MRC757/ESP32-WWVB-NTP-Time-Server/TimeManager.h

/**
 * @file      TimeManager.h
 * @brief     Internal Time Management for WWVB Clock
 * @details   Maintains time between WWVB syncs using ESP32 millis()
 */

#ifndef TIMEMANAGER_H
#define TIMEMANAGER_H

#include <Arduino.h>
#include <stdint.h>

// ============================================================================
// Data Structures
// ============================================================================

/**
 * @brief Structure to hold date and time
 */
struct ClockTime {
    uint16_t year;      // Full year (e.g., 2025)
    uint8_t month;      // Month (1-12)
    uint8_t day;        // Day of month (1-31)
    uint8_t hour;       // Hour (0-23)
    uint8_t minute;     // Minute (0-59)
    uint8_t second;     // Second (0-59)
};

// ============================================================================
// TimeManager Class Definition
// ============================================================================

/**
 * @brief Time Manager Class
 * @details Maintains internal time using ESP32 millis() timer
 *          Time is stored as UTC and converted to local time on request
 */
class TimeManager {
public:
    /**
     * @brief Constructor
     */
    TimeManager();
    
    /**
     * @brief Set the current UTC time
     * @param year Full year (e.g., 2025)
     * @param month Month (1-12)
     * @param day Day of month (1-31)
     * @param hour Hour (0-23)
     * @param minute Minute (0-59)
     * @param second Second (0-59)
     */
    void setTime(uint16_t year, uint8_t month, uint8_t day,
                 uint8_t hour, uint8_t minute, uint8_t second);
    
    /**
     * @brief Update internal time (call once per second)
     * @details Increments internal second counter based on millis()
     */
    void tick();
    
    /**
     * @brief Get current UTC time
     * @return ClockTime structure with UTC time
     */
    ClockTime getUTCTime();
    
    /**
     * @brief Get current local time with UTC offset and DST
     * @param utcOffset Hours offset from UTC (e.g., -5 for EST)
     * @param dst True if Daylight Saving Time is active
     * @return ClockTime structure with local time
     */
    ClockTime getLocalTime(int8_t utcOffset, bool dst = false);
    
    /**
     * @brief Get Unix timestamp (seconds since Jan 1, 1970)
     * @return Unix timestamp
     */
    uint32_t getUnixTime();

    /**
     * @brief Get current milliseconds within the second (0-999)
     * @details Computed on-the-fly from accumulated millis, no side effects
     * @return Milliseconds (0-999)
     */
    uint16_t getMilliseconds();

    /**
     * @brief Get a coherent (seconds, milliseconds) pair, safe against second-boundary races.
     * @param outUnixSeconds  Output: current Unix timestamp (integer seconds)
     * @param outMillis       Output: milliseconds within the current second (0–999)
     */
    void getTimeSnapshot(uint32_t& outUnixSeconds, uint16_t& outMillis);
    
    /**
     * @brief Set time from Unix timestamp
     * @param unixTime Seconds since Jan 1, 1970
     */
    void setUnixTime(uint32_t unixTime);

    /**
     * @brief Correct the integer second without disturbing the sub-second accumulator.
     * @details Use this for DS3231 drift corrections where only the integer second changes.
     *          Unlike setUnixTime(), this does NOT reset _accumMillis or _lastTickMillis,
     *          preserving the NTP fractional-second accuracy accumulated since the last sync.
     * @param unixTime  The corrected Unix timestamp (integer seconds)
     */
    void setUnixTimePreserveMillis(uint32_t unixTime);

    /**
     * @brief Set the sub-second accumulator after a setUnixTime() call.
     * @details Call immediately after setUnixTime() to restore sub-second phase.
     *          Typical use: pass irqProcessingDelay (ms) so the clock reads
     *          corrected_second + irq_latency, matching the true time at IRQ fire.
     * @param ms  Milliseconds within the current second (0–999)
     */
    void setSubSecondOffset(uint16_t ms);

    /**
     * @brief Lock the timebase to an external second-boundary anchor.
     * @details The supplied unixSecond is the UTC second that began at edgeMicros.
     *          Subsequent reads derive both whole seconds and sub-second phase from
     *          the elapsed microseconds since that anchor instead of free-running
     *          solely on millis().
     * @param unixSecond UTC second at the boundary
     * @param edgeMicros micros() captured at that second boundary
     */
    void setRTCPhaseAnchor(uint32_t unixSecond, uint32_t edgeMicros);

    /**
     * @brief Clear any external phase lock and fall back to millis()-based holdover.
     */
    void clearRTCPhaseAnchor();

    /**
     * @brief True when the clock is currently disciplined by an external second edge.
     */
    bool hasRTCPhaseAnchor() const;

    
    /**
     * @brief Check if time has been set (synced at least once)
     * @return true if time has been set
     */
    bool isTimeSet();
    
    /**
     * @brief Get seconds since last time set
     * @return Seconds elapsed since setTime() was called
     */
    uint32_t getSecondsSinceSync();
    
    /**
     * @brief Calculate day of week (0=Sunday, 6=Saturday)
     * @param year Full year
     * @param month Month (1-12)
     * @param day Day of month (1-31)
     * @return Day of week (0-6)
     */
    static int calculateDayOfWeek(uint16_t year, uint8_t month, uint8_t day);
    
    /**
     * @brief Check if year is a leap year
     * @param year Full year
     * @return true if leap year
     */
    static bool isLeapYear(uint16_t year);
    
    /**
     * @brief Get number of days in a month
     * @param year Full year (needed for February leap year check)
     * @param month Month (1-12)
     * @return Number of days in the month
     */
    static uint8_t daysInMonth(uint16_t year, uint8_t month);

private:
    // Internal time storage (UTC)
    uint16_t _year;
    uint8_t _month;
    uint8_t _day;
    uint8_t _hour;
    uint8_t _minute;
    uint8_t _second;
    
    // Timing tracking
    unsigned long _lastTickMillis;      // millis() at last tick
    unsigned long _syncMillis;          // millis() when time was set
    bool _timeSet;                      // Has time been set?
    
    // Accumulated milliseconds for sub-second accuracy
    uint32_t _accumMillis;   // uint32 prevents overflow up to ~49 days

    // Optional RTC-disciplined phase anchor
    bool _rtcPhaseLocked;
    uint32_t _rtcAnchorUnixSecond;
    uint32_t _rtcAnchorMicros;
    
    /**
     * @brief Increment internal time by one second
     */
    void incrementSecond();
    
    /**
     * @brief Normalize time values after arithmetic operations
     */
    void normalizeTime();
    
    /**
     * @brief Add hours to current time (can be negative)
     * @param hours Hours to add (positive or negative)
     */
    void addHours(int8_t hours);

    /**
     * @brief Convert Unix seconds to calendar fields.
     */
    static ClockTime unixToClockTime(uint32_t unixTime);
};

#endif // TIMEMANAGER_H
