MRC757/ESP32-WWVB-NTP-Time-Server/(commit log)

2026-03-23 Fix tracking timeout, antenna selection, time lag, and build compatibility
    - Fix tracking mode reception timeout starting at schedule time instead of
    actual :55 write; timeout now resets when Control 0 is written so syncs
    scheduled more than 30s before :55 no longer immediately time out
    - Fix tracking mode always using Ant1 regardless of history; now selects
    antenna with higher historical success count, matching normal mode behavior
    - Fix normal-mode sync web callback silently no-op when tracking pending
    - Fix ~1s display lag: syncFromDS3231() now requires ≥2s discrepancy before
    calling setTime(), eliminating the tick()/DS3231 second-boundary race that
    rolled back TimeManager eve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
    [CaptivePortal.cpp, CaptivePortal.h, ES100.cpp, ES100.h, NTPServer.cpp, NTPServer.h, ReceptionHistory.cpp, ReceptionHistory.h]
2026-03-23 Update MODIFICATIONS.md with 2026-03-23 changes
    Documents fixes 8–14: tracking timeout, antenna selection, normal sync
    callback, 1-second display lag, latency compensation, SPIFFS build fix,
    and favicon.ico handler.
2026-03-25 Improve time accuracy: IRQ latency, NTP RTT, tracking sanity check, NTP RFC compliance
    F1 Capture ES100 IRQ timestamp in ISR; measure IRQ-to-handler delay
    F2 Apply measured IRQ delay as whole-second correction (1s floor) for normal
    mode; tracking back-computes Unix second from :55-write anchor + WWVB field
    F3 10s DS3231 read-back suppression after WWVB sync (trust window)
    F4 uint32_t _accumMillis to prevent silent overflow at 65s
    F5 Atomic NTP timestamp via getTimeSnapshot() double-read pattern
    F6 setUnixTimePreserveMillis() preserves sub-second accumulator on DS3231 drift corrections
    F7 Dynamic NTP Root Dispersion grows at DS3231 2ppm drift rate since last sync
    F8 NTP stratum de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
    [NTPServer.cpp, NTPServer.h, TimeManager.cpp, TimeManager.h, config.h, wwvb_clock.ino]
2026-03-27 Add time accuracy chain section and clarify ES100 crystal note in README
    Documents each stage of the WWVB→NTP→PC→time.gov error chain with typical
    error magnitudes and recommended Windows NTP poll interval settings.
    Clarifies that the ES100-MOD includes the 16 MHz crystal onboard.
2026-04-06 Add nightly normal-mode anchor and remove 1s floor from normal sync
    Nightly anchor (config.h, wwvb_clock.ino):
    - Force a full normal-mode WWVB sync at the start of each night (10 PM local)
    and retry every hour until one succeeds, then resume tracking mode.
    - Prevents tracking mode from perpetuating clock errors larger than the ES100's
    ±4 s timing tolerance, which cause every tracking sync to reinforce rather than
    correct the error (self-perpetuating cycle).
    - Controlled by NIGHTLY_NORMAL_SYNC_HOURS (default 20h); lastNormalSuccessMillis
    tracks the last successful full-frame decode.
    Remove 1s floor from normal-mode IRQ delay (wwvb_clock.ino):
    - The 1s minimum floor overcorrected by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
    [TimeManager.h, config.h, wwvb_clock.ino]
2026-04-12 Fix sub-second phase loss on tracking snaps; add real-world accuracy to README
    - Add TimeManager::setSubSecondOffset() to restore _accumMillis after
    setUnixTime() calls, preventing the clock from snapping to .000ms on
    every tracking snap and introducing up to 500ms of NTP timestamp jitter
    - Apply setSubSecondOffset(irqProcessingDelay) after both tracking and
    normal-mode syncs so NTP fractional timestamps are stable between polls
    - Add real-world accuracy example to README Time Accuracy Chain section:
    -0.117s PC offset after 48h continuous operation, root dispersion
    explanation, and w32tm filter convergence note
    [TimeManager.cpp, TimeManager.h, wwvb_clock.ino]
2026-04-16 Add Sync Status display page; clean up Clock/UTC pages
    - New PAGE_SYNC page shows 48h sync count, source, ES100 mode, signal
    quality, per-antenna success counts, and last WWVB sync time
    - Clock and UTC pages now show last WWVB sync time with color thresholds
    (green < 12 h, yellow < 24 h, red ≥ 24 h)
    - Reception chart removed from Sync Status page (shown on Clock/UTC only)
    - Row spacing on Sync Status page increased (rowH 20→24, divider gap 6→8)
    - README updated: 5-page navigation, new page descriptions, updated
    sync color thresholds, signal quality now noted on device display
2026-04-17 Document clone DS3231 drift issue in README
    Clone DS3231 modules (HiLetgo etc.) commonly drift 30–70 ppm due to
    off-spec or aged crystals — 15–35× outside the Maxim spec of ±2 ppm.
    Added a detailed troubleshooting section covering symptoms, how to
    identify a suspect module by date code, and recommended genuine modules
    (Adafruit #3013, SparkFun BOB-12708). Also flagged the hardware table.
2026-04-23 Fix +1s phase error after DS3231 write on SQW boundary
    processDS3231SquareWave() was calling setRTCPhaseAnchor(anchorUnix+1,
    edgeMicros) immediately after an rtc.adjust() write — anchoring second
    M+1 to the old oscillator's SQW edge rather than M+1's true boundary.
    This caused a +1 s step every time a WWVB sync triggered a DS3231 save
    (tracking or normal mode), followed by slow DS3231 drift on top.
    Fix: return after the write without setting the phase anchor. The DS3231
    oscillator phase resets on adjust(); the next natural SQW edge (≤1 s away)
    uses the rtc.now() path to re-lock cleanly to the freshly-written values.
    [wwvb_clock.ino]
2026-04-24 Discipline NTP phase with DS3231 square wave
    After a DS3231 write the oscillator phase resets to the write moment
    T.ms. Two bugs were present in the SQW re-lock path:
    1. +1 s jump: setRTCPhaseAnchor(M+1, currentEdge) was called on the
    same edge as rtc.adjust(), anchoring second M+1 to the old
    oscillator boundary (fixed in prior commit de2a130).
    2. Sub-second phase loss: the first post-write SQW edge fires at
    T+1.ms, but rtc.now() returns T+1 (integer), so the anchor was
    placed ms early — making the clock slow by that amount each sync.
    Fix: save rtcWriteSubsecMs = getMilliseconds() at write time. On the
    first post-write SQW edge (rtcWriteDonePending path), back-date the
    anch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
    [wwvb_clock.ino]
2026-04-27 Fix SQW phase correction dropped on E2+ edges after DS3231 write
    The write-done handler (E1) correctly back-dated the phase anchor by
    rtcWriteSubsecMs, but the normal edge handler (E2+) overwrote it with
    raw edgeMicros — losing the correction on every subsequent edge. The
    DS3231 SQW fires rtcWriteSubsecMs ms late relative to true time on all
    edges after a write, not just E1, so the correction must persist.
    Symptom: clock held ~rtcWriteSubsecMs slow (up to ~500 ms) from the
    first post-write SQW cycle onward, stable until the next WWVB sync
    rewrote the DS3231. Observed: −441 ms vs time.gov, 83 min after sync.
    Fix: apply edgeMicros − rtcWriteSubsecMs × 1000 µs on every normal
    SQW ed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
    [wwvb_clock.ino]
2026-04-29 Fix tracking sync drops whole-second IRQ delay, shifts clock 3-4 s
    corrected = the second at which the ES100 IRQ fired. If the main loop
    is stalled 3-4 s handling NTP traffic or display work, setUnixTime(corrected)
    sets the clock back to the IRQ second and setSubSecondOffset only restores
    the fractional remainder — the whole-second elapsed time is never added.
    Normal mode already handles this with an explicit delaySeconds step.
    Apply the same pattern to tracking mode: set to corrected + delaySeconds
    then restore the sub-second fraction.
    [wwvb_clock.ino]
2026-04-29 Update README: trim latency-compensation history, update accuracy to <100ms
    - Latency Compensation bullet: removed historical bug descriptions,
    kept only current behavior
    - Accuracy table: time.gov floor updated to 10-50 ms
    - Overall accuracy: documented sustained <100 ms vs time.gov
    - Real-World Example: replaced previous-result bug sections and
    stale w32tm table with current measured performance
    - Root Dispersion note: reworded to remove bug-era context
2026-05-10 Fix WiFi reconnection: remove blocking delay, add non-blocking retry logic
    Replace blocking delay(5000) in WIFI_STATE_CONNECTED with time-based tracking.
    When disconnect is detected, record timestamp and wait 5 seconds non-blockingly
    before reconnecting. This keeps the main loop responsive to display updates,
    touch input, and ES100 interrupts during network issues.
    Add WIFI_STATE_IDLE reconnection retry: if saved credentials exist, attempt
    reconnection every 30 seconds. This ensures the device automatically reconnects
    when the network becomes available again, instead of staying in IDLE state.
    Benefits:
    - Main loop stays responsive during WiFi issues
    - Display, touch, and WWVB syncs continu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
    [wwvb_clock.ino]
2026-05-11 Fix NTP receive timestamp staleness: re-sample before writing
    The Receive Timestamp (T2) was sampled at the beginning of buildResponse()
    but written much later after ~50 lines of processing. If this processing
    takes >1 second, the timestamp becomes stale, causing NTP clients to see
    an apparent processing delay of 1-3 seconds and compensate by advancing
    their clocks accordingly.
    Fix: Re-sample the time immediately before writing T2, matching the
    pattern already used for the Transmit Timestamp (T3). Both timestamps
    are now guaranteed to be fresh and coherent.
    This explains the 2.89-second error observed on Windows NTP clients
    when the main loop experiences processing delays >1 second.
    Co-Au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
    [NTPServer.cpp]
